tviktinho/OpenRC-AeroLink/docs/images/esp_externo.jpg

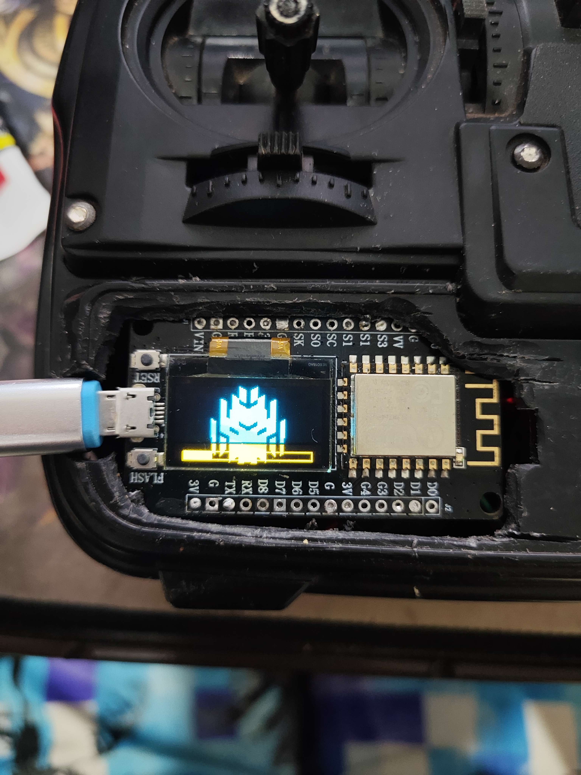
docs/images/esp_externo.jpg
