tviktinho/OpenRC-AeroLink/docs/images/inteiro_pelado.jpg

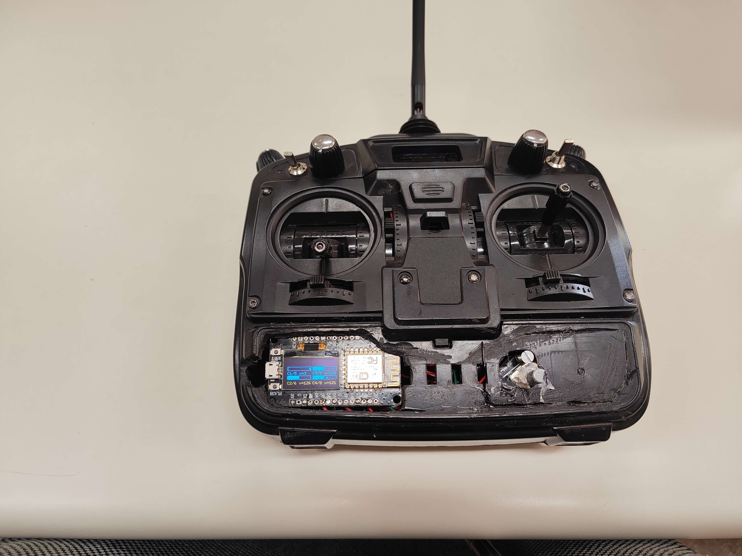
docs/images/inteiro_pelado.jpg
