tviktinho/OpenRC-AeroLink/docs/images/interno.jpg

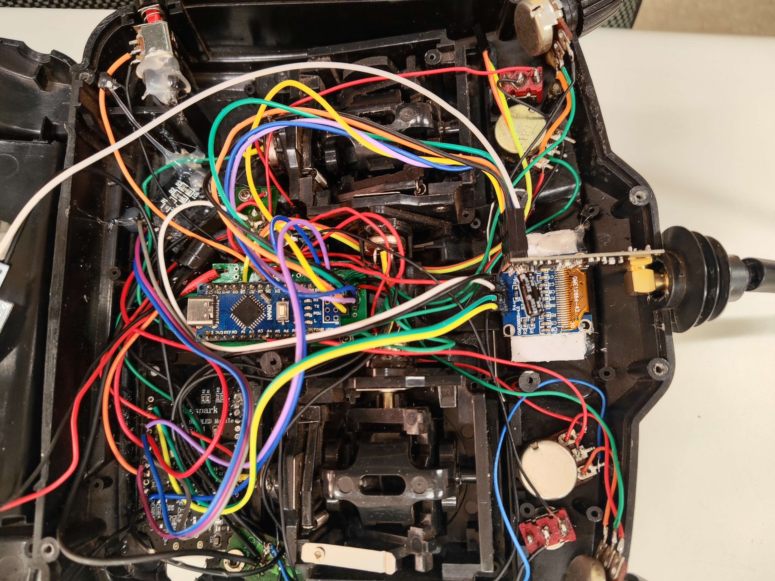
docs/images/interno.jpg
