tviktinho/OpenRC-AeroLink/(commit log)

2025-08-31 Add initial project documentation and firmware
    Added project documentation files and initial firmware for TX and RX modules (ESP8266, ESP32, MEGA, NANO), including source code for each microcontroller. Also included Python scripts for PC-side simulation and testing. This establishes the base for a modular TX/RX system supporting both simulators and real RC models.
2025-08-31 Add README docs for firmware and Gerber files
    Added initial README.md documentation for RX_ESP32, RX_MEGA, RX_NANO, TX_ESP8266, and TX_NANO firmware directories, detailing features, pinouts, and usage notes. Also added Gerber_UNIVERSAL.zip to hardware directory for PCB manufacturing.
2025-09-01 Update UART to 38400 and improve boot UX on ESP8266
    Changed the ESP8266 firmware to use SoftwareSerial on D3 at 38400 bps for UART communication with the Nano, and updated the Nano firmware to transmit at 38400 bps. Improved the ESP8266 boot splash to show a project title and loading animation instead of a bitmap. Adjusted buzzer pin and logic, and refactored code for clarity and maintainability.
    [NANO_TX.ino, TX_ESP8266.ino]
2025-09-04 Refactor TX_NANO and TX_ESP8266 for encoder support
    Major refactor to TX_NANO firmware: adds rotary encoder support (steps and button with short/long click detection), updates UART payload to include encoder delta and click counters, and improves input handling. TX_ESP8266 firmware updated to handle new payload format, support menu navigation via encoder, and refactored UI/menu logic. PC test script simplified and updated for new payload format.
    [NANO_TX.ino, TX_ESP8266.ino]
2025-09-06 Add local encoder support and improve menu/calibration UI
    Implemented support for a local rotary encoder on the ESP8266, including debounced quadrature decoding and integration with UI navigation. Refactored menu rendering to use dynamic item text and a circular menu, and added a full-screen calibration mode displaying live channel and switch states. Serial baud rate updated to 115200. In mega_working.py, changed SW2 key mapping from 'f' to 'r'.
2025-09-14 Add PC bridge app and build configuration
    Added initial PC bridge application under software/pc/app with supporting files, requirements, and build script. Included PyInstaller spec file and build artifacts for OpenRC-AeroLink-Bridge. Also added VSCode Arduino configuration and updated TX_ESP8266 firmware.
2025-09-14 Add images, update docs, and clean build artifacts
    Added new images to the documentation, updated the application README, and made changes to the main application script and build scripts. Removed PyInstaller build artifacts and the .spec file, added a .gitignore for common Python and build files, and introduced a script to clean build artifacts. Updated requirements.txt to reflect current dependencies.
2025-09-14 Switch to FreeSimpleGUI and update build process
    Replaced PySimpleGUI with FreeSimpleGUI as the preferred GUI library in both code and requirements. Updated the build script to install dependencies from PyPI and collect FreeSimpleGUI assets. Improved error handling and logging in bridge_core.py. Removed the obsolete mega_tests.py script.
    [bridge_core.py, main.py]
2025-09-15 Add live potentiometer and switch status to GUI
    Introduces a callback mechanism in BridgeWorker to emit live data updates, which are now displayed in the GUI as potentiometer bars and switch indicators. The GUI layout is updated to include progress bars for potentiometers and colored indicators for switches S1 and S2, providing real-time feedback to the user.
2025-11-18 Add ESP32 RX firmware and ground station bridge
    Added new ESP32_RX firmware with dual-core flight controller and radio receiver logic, including PID tuning and telemetry via UART. Introduced RPi ground station bridge (fc_bridge.py) and configurador.html for web-based PID configuration and gyro calibration. Migrated and reorganized RX firmwares for MEGA and NANO, added 14-BRIZA firmware, and updated TX_ESP8266 for serial debug and baud rate compatibility. Minor improvements to NANO_RX for packet LED and debug output.
2025-11-19 Add RC calibration and telemetry enhancements
    Expanded ESP32_RX firmware to support RC calibration, trims, and thread-safe serial communication. Updated HTML ground station UI with tabs, HUD, and improved telemetry display. Refactored Python bridge to support new telemetry fields, GPS parsing, and hardware initialization for barometer and GPS.
2026-03-21 Add ESP32 flight controller README
    Add comprehensive README for the ESP32 flight controller (firmware/ESP32). Documents features (elevon mixing, nRF24L01 radio, MPU6050 AHRS, MAVLink v1, NVS, failsafe), hardware requirements, pin wiring diagrams, radio packet format, mixing/AHRS algorithms, telemetry/parameters, build/upload steps, test checklist, calibration tips, file layout and license. Provides users with setup, tuning and compatibility guidance for the OpenRC AeroLink ESP32 firmware.
2026-03-21 Add stabilizer, aux channels; disable MAVLink
    Refactor ESP32 firmware: implement a rate-mode stabilizer using MPU gyro with calibration, add three auxiliary servo outputs and channel mappings, and reorganize pin/PWM setup (ESC arming, servo periods). Make MPU optional (falls back to manual), improve failsafe handling, normalize radio packet parsing and RC->µs conversions, and move trims to NVS with save/load helpers. MAVLink integration is commented out/disabled (placeholders kept) and related code cleaned up; general code style and comments updated.
    [ESP32.ino]
2026-03-22 Add TF-IDF script; refactor ESP32 PWM outputs
    Adds exercicioRI.py: a TF-IDF / cosine-similarity demo using a restricted vocabulary and three example queries (tokenization, TF weighting 1+log10, IDF log10(N/n_i), TF-IDF, vector norms and ranking). Intended for the Activity 08 assignment.
    Refactors firmware/ESP32/ESP32.ino: reworks PWM/servo handling to 8 channels (CH1..CH8), replaces old servo/ESC variables, updates channel mapping, and changes loop to publish raw PWM passthrough for all channels. Also disables WiFi/Bluetooth at startup to save power, increases I2C timeout, adds attach result logging for servos, sets initial channel outputs, and preserves SBUS/MAVLink comments. Several legac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
    [ESP32.ino]
2026-04-30 Add PWM MEGA RX, NANO_RX v2 and PC parsers
    Rework MEGA_RX to read PWM pulses from A8..A15 (pin-change ISR), convert pulse widths to 0..255 and stream CSV to USB; add configuration for channel ranges, inversion and signal timeout, and update MEGA README. Add new NANO_RX firmware (NANO_RX_v2.0) implementing servo/ESC outputs, zagi-mix logic, failsafe and ESC arming; add a radio-channel identification sketch (IDENTIFICA_CANAIS_RX) for debugging. Update 14-BRIZA firmware: change ESC pin (9 -> 3) and reduce elevon gains. Rename TX_NANO file path. Improve PC-side tools (SIM.py, bridge_core.py, mega_working.py) by centralizing a parse_serial_payload() helper that accepts either 8-channel or 8+2 CSV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
    [14-BRIZA.ino, IDENTIFICA_CANAIS_RX.ino, MEGA_RX.ino, NANO_RX_v2.0.ino, NANO_TX.ino]
2026-04-30 Parse serial payloads with optional switches
    Add a reusable parse_serial_payload(line) helper to SIM.py, mega_working.py and app/bridge_core.py to centralize and harden serial line parsing. The parser accepts payloads with either 8 (pots only) or 10 (pots + two switches) comma-separated integers, returns (pots, s1_raw, s2_raw, has_switches), and gracefully ignores malformed lines. Replace duplicated parsing logic with calls to this helper and guard edge-triggered key taps so they only fire when switches are present. Also update a printed message to note switches are optional.
    [SIM.py, bridge_core.py, mega_working.py]
2026-05-20 Adicionar upgrade ELRS (Fase 0 + Fase 1): NANO_TX v2 com CRSF + docs Heltec V2
    Habilita migração incremental do link nRF24 2.4 GHz para ExpressLRS 900 MHz
    mantendo compatibilidade total com os receptores antigos durante a transição.
    Fase 0 — Preparação:
    * firmware/legacy/NANO_TX_v1_nrf24.ino: restaurado do commit 77a5226 (o
    firmware/TX_NANO/NANO_TX/NANO_TX.ino no main ficou com código do FC
    ESP32 por engano; o legacy preserva a versão original real).
    Fase 1 — ELRS oficial para validação:
    * firmware/TX_NANO_v2/crsf_tx.h: encoder CRSF v3 (RC_CHANNELS_PACKED 0x16),
    CRC8 polinômio 0xD5, pack de 16 canais 11-bit em 22 bytes, helpers de
    conversão byte→canal e us→canal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
2026-05-27 Adicionar firmware ESP32 FC v2 com entrada CRSF do RX ELRS 915 MHz
    Fecha o ciclo end-to-end da Fase 1: agora o RX 915 MHz chega no ESP32 do
    avião via CRSF e gera PWM nos servos/ESC. Antes só validava no painel web
    do Heltec, sem conseguir voar de verdade.
    firmware/ESP32_FC_v2/crsf_rx.h:
    * Parser CRSF state machine (WAIT_SYNC -> WAIT_LEN -> COLLECT_PAYLOAD),
    reentrante, sem alocação dinâmica.
    * Decodifica RC_CHANNELS_PACKED (0x16), 16 canais 11-bit.
    * CRC8 polinômio 0xD5, sanity check de LEN.
    * Helpers: crsf_channel_to_us(), crsf_channel_to_byte(),
    crsf_ch8_to_switches() (reverte o bitmask do CH8 do NANO_TX_v2 em
    bits SW1..SW4).
    * API leve: feed(), hasNewFrame(), getChannel(), la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
    [ESP32.ino, crsf_rx.h]
2026-05-27 Adaptar Heltec_V2_TX_ELRS para o fluxo de hardware.json do ELRS 4.x
    O Configurator 4.x removeu o campo "Custom Hardware Layout" da UI. Em vez
    disso, o ELRS 4.x espera que hardware custom seja definido via web UI no
    primeiro boot, arrastando um hardware.json em http://10.0.0.1/hardware.html.
    Mudanças:
    * firmware/Heltec_V2_TX_ELRS/hardware.json: novo arquivo no formato
    esperado pelo /hardware.html (sem comentários, com todos os campos que
    o parser do firmware espera: power_*, screen_reversed, led_*_invert,
    radio_busy=-1, radio_rxen/txen=-1). É o arquivo a ARRASTAR.
    * firmware/Heltec_V2_TX_ELRS/heltec_v2_sx1276.json: mantido como
    documentação (versão comentada do layout). READM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
2026-05-27 Aplicar correções da review do Copilot no PR #3
    Endereça 6 comentários (3 críticos, 3 menores) do review automático.
    CRÍTICOS:
    1. Baud rate 420000 → 400000 (correção AVR @ 16 MHz)
    * ATmega328P não gera 420000 baud com precisão (com U2X=1 e UBRR=4,
    a UART produz 400000 real com 4,76 % de erro se você pedir 420000).
    * Mudamos CRSF_BAUDRATE = 400000 em crsf_tx.h e crsf_rx.h. AVR gera
    400000 com 0 % de erro. ELRS v3+ tem auto-detect; v4.x permite
    configurar manualmente no painel web.
    * Adicionada nota técnica grande no header do crsf_tx.h.
    * READMEs atualizados para 400 000 com nota de rodapé explicando.
    2. Mito "ESP32 é 5V-tolerant" — divisor obr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
2026-05-27 Adicionar platformio.ini para ESP32 FC v2 e NANO_TX v2
    Permite compilar/upload via PlatformIO (CLI ou extensão VSCode) sem
    depender do Arduino IDE. Mantém compatibilidade com Arduino IDE — os
    arquivos .ino e .h continuam na raiz das pastas, então quem quiser
    abrir no Arduino IDE 2.x funciona igual.
    firmware/ESP32_FC_v2/platformio.ini:
    * board = esp32dev (ESP32 Dev Module clássico)
    * upload_speed 921600, monitor_speed 115200
    * lib_deps: ESP32Servo
    * monitor_filters: esp32_exception_decoder + time
    firmware/TX_NANO_v2/platformio.ini:
    * DUAS envs:
    - nano_old_bootloader (padrão, p/ clones CH340) — baud 57600
    - nano_new_bootloader (Nano original raro) — baud 115200
    Escolha v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
2026-05-27 Fix: mover src_dir para seção [platformio] global nos platformio.ini
    PIO ignora a chave `src_dir` quando ela está dentro de uma seção [env:...]
    (emite warning "Ignore unknown configuration option `src_dir`"). Com o
    src_dir ignorado, o PIO cai no padrão `src/`, não encontra o .ino na raiz
    da pasta de firmware e a compilação falha com:
    undefined reference to `setup()`
    undefined reference to `loop()`
    Solução: mover `src_dir = .` para a seção global [platformio] em ambos os
    arquivos. Adicionado comentário no topo explicando essa pegadinha para
    quem for editar no futuro.
    Reportado pelo @tviktinho rodando `pio run -t upload` no ESP32_FC_v2.
2026-05-28 Adicionar MAVLink v1 (HEARTBEAT + RC_CHANNELS_RAW) ao ESP32 FC v2
    Permite ver os RC inputs no Mission Planner / QGroundControl via USB.
    Implementação manual (sem dependência da pasta mavlink/ legada de ~600KB):
    firmware/ESP32_FC_v2/mavlink_min.h:
    * CRC X.25 (CCITT) com accumulate byte-a-byte
    * Frame layout MAVLink v1: STX 0xFE | LEN | SEQ | SYS | COMP | MSG | PAYLOAD | CRC
    * Helper genérico mav_send_frame()
    * mav_send_heartbeat() — type=FIXED_WING, autopilot=GENERIC, mavlink_ver=3
    * mav_send_rc_channels_raw() — 8 canais em µs + RSSI
    * Constantes MAV_TYPE_*, MAV_STATE_*, MAV_MODE_FLAG_*
    * CRC_EXTRA fixo: HEARTBEAT=50, RC_CHANNELS_RAW=244 (gerados do XML oficial)
    firmware/ESP32_FC_v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
    [ESP32.ino]
2026-05-28 Limpar artefatos do PlatformIO acidentalmente comitados
    O commit anterior (MAVLink) puxou junto firmware/ESP32_FC_v2/.pio/libdeps/
    porque eu rodei `git add firmware/ESP32_FC_v2/` enquanto havia cache local
    do PIO. Esses arquivos são baixados automaticamente em cada máquina pelo
    `pio run` — não devem estar versionados.
    * .gitignore: adiciona .pio/, .pioenvs/, .piolibdeps/ e *.hex.bak
    * git rm --cached: remove os arquivos do tracking sem deletar do disco
    A pasta local .pio/ continua existindo no worktree para o build seguir
    funcionando — só não é mais versionada.
2026-05-28 Adicionar serial_baudrate=400000 no hardware.json do Heltec V2
    Sem esse campo, ELRS assume 420000 baud no input CRSF (default). Mas o
    Nano TX v2 manda em 400000 (AVR @ 16MHz não consegue gerar 420k limpo).
    Resultado: Heltec não decodifica nada do Nano, fica em "NO HANDSET",
    não transmite ELRS, RX nunca acha o sinal e LED do RX fica piscando lento.
    Adicionar 400000 explicitamente no hardware.json alinha os dois lados.
    Reportado pelo @tviktinho: LED do RX piscando lento mesmo com UID e
    versão idênticos. Causa-raiz é o baud rate mismatch entre Nano (400k)
    e Heltec (420k default).
    Usuário precisa re-arrastar o hardware.json em /hardware.html do Heltec
    pra aplicar a nova config.
2026-05-28 Adicionar CRSF Sniffer minimalista pra ESP32-C3 mini
    Firmware super-simples pra validar o link ELRS sem precisar do FC v2:
    recebe CRSF do RX 915M na UART1 e imprime canais com barras visuais
    na Serial USB.
    firmware/ESP32_C3_CRSF_SNIFFER/CRSF_Sniffer.ino:
    * Reaproveita crsf_rx.h do FC v2 (mesmo parser, mesma lib)
    * UART1 do ESP32-C3 em GPIO 2/3 (livres, sem strapping nem conflito USB)
    * Print 10 Hz: [LINKED]/[NO LINK] + ok/bad counters + 4 canais com
    barras ASCII [##....] e valor em µs
    * Eventos de transição "LINK ESTABELECIDO" / "LINK PERDIDO" pra
    diagnóstico mais claro
    firmware/ESP32_C3_CRSF_SNIFFER/platformio.ini:
    * board = esp32-c3-devkitm-1 (genérico, cobre maioria dos clones)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
2026-05-28 Fix: aumentar power_values no hardware.json do Heltec V2
    O hardware.json anterior tinha power_default=1 (= -6 dBm = 0.25 mW) e
    power_max=3 (= 14 dBm = 25 mW), limitando o TX a níveis baixíssimos.
    Resultado: max-power no JSON exportado de Import/Export ficava preso
    em 2 (= 1 mW), independente do que o usuário configurasse no Hardware
    Layout via UI.
    Reportado pelo @tviktinho: bind RF não fechava (LED do RX piscando
    lento, sniffer mostrando "NO LINK") mesmo com TX e RX em 4.0.1,
    mesma binding phrase, mesmo UID 190,168,40,211,143,5. Causa-raiz era
    potência efetiva insuficiente (1 mW) pra alcançar o RX a 30 cm.
    * power_values: [-9,-6,0,14] -> [-9,-6,0,14,17,20]
    Adiciona +17 d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
2026-05-28 Adicionar models_max_power.json com max-power=5 explícito
    Diagnóstico: mesmo com hardware.json setando power_default=5 e
    power_max=5, o models.json exportado continua mostrando max-power=2.
    Algo no firmware 4.0.1 do DIY ESP32 RFM95 TX está sobrescrevendo o
    default ao boot, ou o models.json original (com max-power=2) está
    sendo aplicado depois do hardware.json.
    Workaround: importar este models_max_power.json via aba Import/Export.
    Tem max-power=5 explícito (= +20 dBm = 100 mW real no SX1276 do Heltec).
    Se persistir após RST, problema resolvido. Se voltar pra 2, é hardcode
    do firmware e precisa de outra abordagem.
    UID 190,168,40,211,143,5 preservado. button-actions preservado.
2026-05-28 Documentar troubleshooting completo da Fase 1 (RX defeituoso)
    Reescreve firmware/Heltec_V2_TX_ELRS/TROUBLESHOOTING.md com o
    aprendizado de ~8h de debug do bind ELRS no Heltec V2.
    Conteúdo do novo doc:
    * Resumo executivo (sintoma, diagnóstico, solução, tempo)
    * Cronologia detalhada das 9 hipóteses testadas e descartadas
    * Teste decisivo de proximidade extrema com cálculo de viabilidade RF
    * Diagnóstico final: RX 915M chinês genérico defeituoso/clone falso
    * 8 lições aprendidas (compra de RX, max-power hardcoded, hardware.json
    runtime, Configurator v1.7.11 limitações, Erase before flash,
    Bound vs Linked, riscos elétricos)
    * Checklist de debug pra próxima vez (ordem sistemá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
2026-05-28 Adicionar firmware Heltec V2 TX customizado (LoRa raw, sem ELRS)
    Fase 2 do upgrade: substitui o ExpressLRS oficial por protocolo próprio
    sobre LoRa raw. Resolve as limitações descobertas durante o debug da
    Fase 1 (max-power hardcoded em 1 mW, dependência de Custom Hardware
    Layout, bugs de pré-release).
    firmware/Heltec_V2_TX_custom/lora_link.h:
    * Define protocolo "lora_link" — frame de 28 bytes:
    STX1 0xC4 | STX2 0x71 | LEN | SEQ | 22 bytes payload | CRC16
    * Payload é IDÊNTICO ao CRSF_FRAMETYPE_RC_CHANNELS_PACKED (16 canais
    11-bit packed) — facilita reuso de código no RX
    * CRC-16-CCITT (poly 0x1021, init 0xFFFF)
    * Parâmetros LoRa: 915 MHz FCC, BW 500 kHz, SF7, CR 4/5, SYNC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
    [Heltec_V2_TX.ino, crsf_rx.h, lora_link.h]
2026-06-02 Adicionar receptor ESP32-C3 nRF24 V2 → PPM single-wire
    Receptor caseiro para pilotar FC Betaflight (Matek F411-RX / Mobula6)
    com o controle de mão NANO_TX_V2 existente, sem precisar de RX comercial.
    Hardware:
    - ESP32-C3 Super Mini (RISC-V, USB-C nativo)
    - nRF24L01 PA+LNA em SPI (SCK=4, MISO=5, MOSI=6, CSN=7, CE=10)
    - Saída PPM positivo via RMT bit-bang no GPIO21
    Protocolo:
    - Recebe PacketRF V2 (p[8] + s1 + s2) em 250kbps, ch76, addr "00001"
    - Emite PPM 8ch a ~50Hz (HIGH 300us + LOW variável + sync 8ms)
    - Failsafe automático se RX timeout > 200ms
    Mapeamento V2 → PPM (AETR + AUX):
    - CH1 Roll, CH2 Pitch, CH3 Throttle, CH4 Yaw
    - CH5 AUX1 (s1), CH6 AUX2 (s2), CH7/8 AUX3/4 (pots aux)
    S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
    [main.cpp]
2026-06-07 Adicionar NANO_TX v3 — trims digitais (PCF8574) + AUX + EEPROM
    Novo transmissor baseado no v2, mantendo o protocolo nRF24/CRSF idêntico
    (compat com todos os RX do projeto). Mudanças na camada de entrada:
    - Trims digitais via PCF8574 @ 0x20 (4 eixos x +/-, 8 botões)
    - Botão AUX binário em D2 (INPUT_PULLUP) -> CH7
    - Calibração de gimbal e offsets de trim persistidos em EEPROM
    (magic+versão, EEPROM.put + commit diferido de 2 s pra proteger
    contra desgaste)
    - Debounce 2 amostras + auto-repeat 4 Hz após 600 ms
    - Faixa de trim +/-15, passo +/-1 (config.h)
    - Scanner I2C no boot (Serial @ 115200 antes do CRSF assumir)
    - Código modular (config/storage/inputs/trims/radio/crsf)
    Compil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
2026-06-16 ESP32_FC_v2: link ELRS/CRSF + MAVLink completo (RC, ATTITUDE, GPS)
    Fecha o ciclo end-to-end com gear ELRS comercial (RadioMaster Pocket 2.4G +
    BetaFPV Nano RX) e telemetria no Mission Planner. Validado em bancada.
    - CRSF: baud 400000 -> 420000 (RX ELRS comercial fala 420k)
    - Canais remapeados para AETR (CH1=roll, CH2=pitch, CH3=thr, CH4=yaw)
    - CH5 arma/desarma motor; CH8 alterna modo manual/estabilizado
    - MAVLink v1: RC_CHANNELS_RAW (ordem nativa), ATTITUDE (horizonte),
    GPS_RAW_INT + GLOBAL_POSITION_INT, STATUSTEXT rotativo (I2C/PWM/GPS)
    - MPU6050 reintegrado: tenta I2C 0x68 e 0x69, filtro complementar,
    rotacao de 90 graus do frame; scan I2C no boot
    - GPS GY-NEO6MV2 na UART1 (RX=GPIO18,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
2026-06-16 ESP32_FC_v2: auto-nivel (modo angulo) + log de trajeto (LittleFS) + WiFi download
    Adiciona estabilizacao basica e blackbox onboard, validados em bancada.
    - Auto-nivel por CH8/ESTAB: stick comanda angulo-alvo e o MPU corrige
    (P no erro de angulo + D na taxa do gyro). Ganhos conservadores e
    sinais (STAB_ROLL_SIGN/PITCH_SIGN) ajustaveis. Cai p/ MANUAL se sem MPU.
    - Log de trajeto na flash interna (LittleFS): 1 ponto/s quando ha fix de
    GPS, arquivo novo por boot (/trkN.csv), flush por ponto (sobrevive a
    queda de energia). Independe da telemetria (caso de link perdido no longe).
    - WiFi AP sob demanda p/ baixar o log: switch no CH10 > 50%, so desarmado;
    pagina web em 192.168.4.1 lista/b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
    [ESP32.ino]
2026-06-18 ESP32_FC_v2: config em tempo real (params MAVLink/NVS), MAVLink-WiFi e ajustes
    Torna a FC configuravel em voo-livre pelo Mission Planner, sem fio e sem reflash,
    e corrige varios pontos de campo. Validado em bancada.
    Parametros / Mission Planner:
    - Sistema de 18 parametros MAVLink (PARAM_REQUEST_LIST/READ/SET + PARAM_VALUE),
    persistidos na NVS (Preferences), aplicados ao vivo com clamp de seguranca:
    AHRS_RLL_SGN/PIT_SGN, AHRS_SWAP, AHRS_ROT (0/90/180/270 do MPU), STB_RLL/PIT_SGN,
    SRV_REV_L/R, STB_KP/KD_RLL/PIT, STB_MAXANG, MIX_GE/GA/EXPO_E/EXPO_A/DIFF.
    - COMMAND_LONG/COMMAND_ACK: botao de calibracao do MP (PREFLIGHT_CALIBRATION ->
    re-zera gyro + nivela). ACK generico nos demais coman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
    [ESP32.ino]
2026-06-18 ESP32_FC_v2: OTA por WiFi (atualizar firmware sem cabo)
    Pagina /update no AP (porta 80) recebe o firmware.bin por multipart e grava via
    Update.h na particao OTA livre, reiniciando ao final. So no chao (WiFi desarmado).
    Link adicionado na pagina principal. Fluxo: pio run -> upload do .bin pelo browser.
2026-06-18 ESP32_FC_v2: barometro BMP280 (altitude/pressao no MAVLink)
    BMP280 no mesmo I2C do MPU (SDA23/SCL22, 0x76/0x77). Altitude relativa ao solo
    (pressao de solo capturada no boot) + taxa de subida; VFR_HUD (altitude no HUD do
    MP) e SCALED_PRESSURE a 10 Hz. Status no STATUSTEXT. Validado: 0x76 detectado,
    VFR_HUD enviando, altitude lendo.
